learninglabdtu/CardReader/README.md

CardReader
==========

RFID Card Reader lock for closets.
