learninglabdtu/CardReader/BOM.ods

Component types | Component | Value | PCBA | RC number | Link
 | PCB-SENNHEISER_CHARGER_readout
Photo resistors | JP 1, JP 2, JP3, JP4 | EG&G LDR VT935G | 30 in stock | 455-8036 | http://dk.rs-online.com/web/p/ldr-light-dependent-resistors/4558036/?searchTerm=455-8036
Resistors | R3, R6, R9, R12 | 10k | √ | 740-8899 | http://dk.rs-online.com/web/p/overflademontering-faste-modstande/7408899/?searchTerm=740-8899 (http://dk.rs-online.com/web/p/keramiske-flerlags-kondensatorer/7236017/?searchTerm=723-6017)
 | R1, R4, R7, R10 | 330R | √ | 740-8931 | http://dk.rs-online.com/web/p/overflademontering-faste-modstande/7408931/?searchTerm=740-8931
 | R2, R5, R8, R11 | 100k | √ | ?
LEDs | U$1, U$4, U$7, U$ 10 |  | buy! | 708-2747 | http://dk.rs-online.com/web/p/lysdiode-led-med-synligt-lys/7082747/?searchTerm=708-2747
Capacitors | C1, C2, C3, C4 | 10uF | √ | 723-6017 | http://dk.rs-online.com/web/p/keramiske-flerlags-kondensatorer/7236017/?searchTerm=723-6017
 | C5 | 100nF | √ | 698-3327 | http://dk.rs-online.com/web/p/keramiske-flerlags-kondensatorer/6983327/?searchTerm=698-3327
Ics | IC1 | 4050D | 8 in stock | 483-6544 | http://dk.rs-online.com/web/p/buffer-og-line-driver-kombinationer/4836544/?searchTerm=483-6544
 | PCB-CARDLOCK
Resistors | R1, R2 | 1k5 | ~100 in stock | 740-8903 | http://dk.rs-online.com/web/p/overflademontering-faste-modstande/7408903/?searchTerm=740-8903
 | R3, R4, R5, R18 | 270R | √ | 213-2193 | http://dk.rs-online.com/web/p/overflademontering-faste-modstande/2132193/?searchTerm=213-2193
Capacitors | C1, C4, C5 | 100nF | √ | 698-3327 | http://dk.rs-online.com/web/p/keramiske-flerlags-kondensatorer/6983327/?searchTerm=698-3327
 | C3 | 10uF | √ | 723-6017 | http://dk.rs-online.com/web/p/keramiske-flerlags-kondensatorer/7236017/?searchTerm=723-6017
 | C2 | 10uF/12V | buy! | 723-6562
Ics | IC1 | ULN2803A | √ | 646-6311 | http://dk.rs-online.com/web/p/darlington-transistorer/6466311/?searchTerm=646-6311
 | IC2, IC3 | MCP23017SS | √ | 681-1128 | http://dk.rs-online.com/web/p/i-o-expandere/6811128/?searchTerm=681-1128
 | OK1 | LTV826S | √ | 691-2209 | http://dk.rs-online.com/web/p/optoelektroniske-switches/6912209/?searchTerm=691-2209
Relays | Relay1, Relay2 | 5VIM03 | 22 in stock | 422-7029 | http://dk.rs-online.com/web/p/relaeer/4227029/?searchTerm=422-7029
Diodes | D1, D2, D3, D4, D5, D6 | ? | √ | ?
Leds | U$7 | Bi-color LED | 4 in stock | 228-5764 | http://dk.rs-online.com/web/p/lysdiode-led-med-synligt-lys/2285764/?searchTerm=228-5764
Buttons and switches | Reset button, angled |  | 10 in stock | 734-6811 | http://dk.rs-online.com/web/p/trykknapafbrydere-og-trykknapomskiftere/7346811/?searchTerm=734-6811
Others | SG1 | Buzzer | 8 in stock | 771-6917 | http://dk.rs-online.com/web/p/piezo-buzzer-komponenter/7716917/?searchTerm=7716917
Buttons and switches | U$4 | Navigation switch | 3 in stock | 516316 | http://dk.rs-online.com/web/p/joystick-switche/0516316/?searchTerm=516316
Connectors | M04X2 | Analog Detect | 20 in stock | 673-7587 | http://dk.rs-online.com/web/p/printstiftlister/6737587/?searchTerm=673-7587
 | J2 | Temp/Hum sensor connector | 90 in stock |  | http://www.seeedstudio.com/depot/grove-universal-4-pin-connector-p-789.html?cPath=44_80
 | X1, X2 | MSTVB53.5MM | 7 in stock | 3704841 | http://dk.farnell.com/phoenix-contact/1843635/header-vertical-3-5mm-5way/dp/3704841?Ntt=3704841
 | X1 plug, X2 plug |  | 4 in stock | 5089189 | http://dk.farnell.com/phoenix-contact/mcvw-1-5-5-st-3-5/plug-free-r-a-3-5mm-5way/dp/5089189?Ntt=5089189
 | X3 | MSTVB23.5MM | 3 in stock | 3704816 | http://dk.farnell.com/jsp/search/productdetail.jsp?SKU=3704816
 | X3 plug |  | 4 in stock | 5089153 | http://dk.farnell.com/jsp/search/productdetail.jsp?SKU=5089153
 | JP5 | 36 Header Post, single (sidelooking) | ... | 251-8452 | http://dk.rs-online.com/web/p/printstiftlister/2518452/?searchTerm=251-8452
 | JP3, JP9, Arduino headers | 36 Header Post, single (7top,3below) | ... | 251-8632 | http://dk.rs-online.com/web/p/printstiftlister/2518632/?searchTerm=251-8632
 | U$12, U$13 | M04X2 | same as Analog Detect | 251-8648 | http://dk.rs-online.com/web/p/printstiftlister/2518648/?searchTerm=251-8648
Others | RFID |  | 3 in stock |  | http://www.seeedstudio.com/depot/1356mhz-rfid-module-iosiec-14443-type-a-p-196.html?cPath=19_24
Arduinos | Arduino Ethernet |  | buy! | 769-7402 | http://dk.rs-online.com/web/p/processor-og-mikrocontroller-udviklingssaet/7697402/?searchTerm=769-7402
Others | Temperature Hum Sensor |  | 2 in stock |  | http://www.seeedstudio.com/depot/grove-temperaturehumidity-sensor-pro-p-838.html?cPath=25_27
Wires | 50cm wires |  | 10 in stock |  | http://www.seeedstudio.com/depot/grove-universal-4-pin-buckled-50cm-cable-5-pcs-pack-p-928.html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
Boxes | Hammond Box |  | 6 in stock | 773-2953 | http://dk.rs-online.com/web/p/kabinetter-allround/7732953/?searchTerm=773-2953
Schaeffer stuff | Shaeffer aluminium
 | Shaeffer plastics
