learninglabdtu/CardReader/Eagle/PCB-CARDLOCK/PCB-CARDLOCK_bottom.pdf

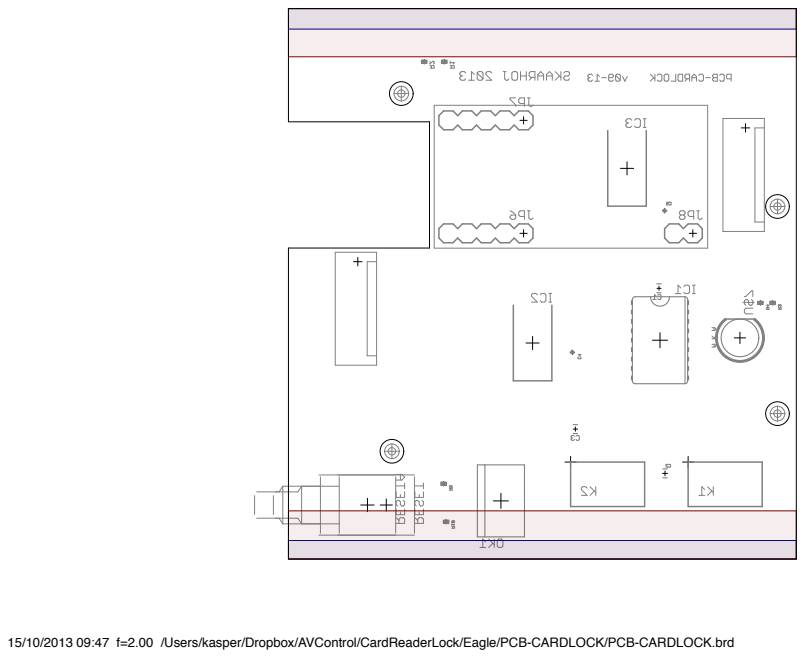
[picture p1: page 1]

15/10/2013 09:47 f=2.00 /Users/kasper/Dropbox/AVControl/CardReaderLock/Eagle/PCB-CARDLOCK/PCB-CARDLOCK.brd
