learninglabdtu/CardReader/Eagle/PCB-CARDLOCK/PCB-CARDLOCK_top.pdf

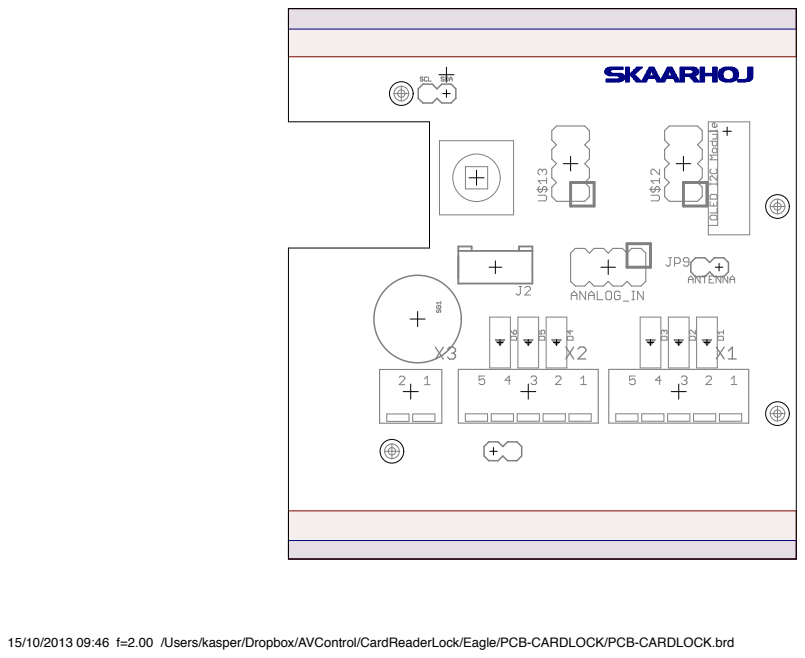
[picture p2: page 1]

15/10/2013 09:46 f=2.00 /Users/kasper/Dropbox/AVControl/CardReaderLock/Eagle/PCB-CARDLOCK/PCB-CARDLOCK.brd
