learninglabdtu/CardReader/Eagle/PCB-SENNHEISER_CHARGER_readout/PCB-SENNHEISER_CHARGER_readout.brd

## EAGLE design Eagle/PCB-SENNHEISER_CHARGER_readout/PCB-SENNHEISER_CHARGER_readout.brd (2014-01-15)

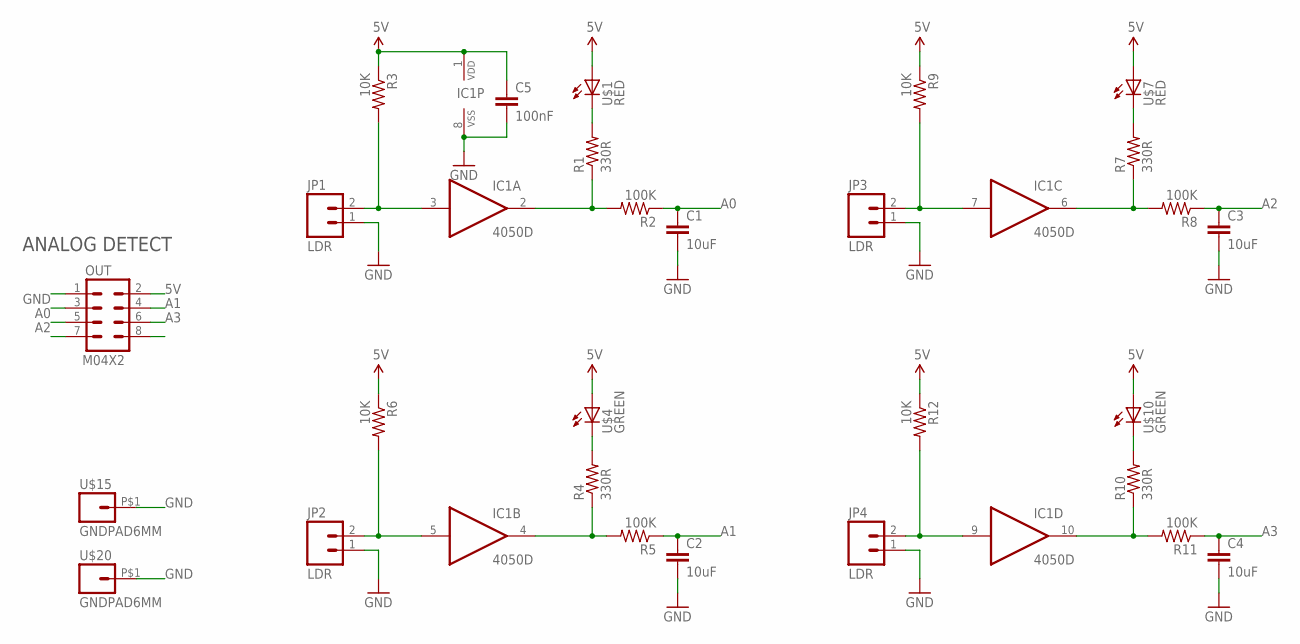
[picture p3: schematic PCB-SENNHEISER_CHARGER_readout.sch, sheet 1]

Parts:
C1, C2, C3, C4: 10uF; 0603-CAP
C5: 100nF; 0603-CAP
IC1: 4050D; SO16
JP1, JP2, JP3, JP4: LDR; 1X02
OUT: M04X2; 2X4
R1, R4, R7, R10: 330R; 0603-RES
R2, R5, R8, R11: 100K; 0603-RES
R3, R6, R9, R12: 10K; 0603-RES
U$1, U$7: RED; LED3MM
U$4, U$10: GREEN; LED3MM
U$15, U$20: GNDPAD6MM; 3.2MMPAD6MM

Connections:
5V: C5.1, IC1.1 (VDD), OUT.2, R3.1, R6.1, R9.1, R12.1, U$1.A, U$4.A, U$7.A, U$10.A
A0: C1.1, OUT.3, R2.1
A1: C2.1, OUT.4, R5.1
A2: C3.1, OUT.5, R8.1
A3: C4.1, OUT.6, R11.1
GND: C1.2, C2.2, C3.2, C4.2, C5.2, IC1.8 (VSS), JP1.1, JP2.1, JP3.1, JP4.1, OUT.1, U$15.P$1, U$20.P$1
unnamed: IC1.3 (I), JP1.2, R3.2
unnamed: R1.2, U$1.K (C)
unnamed: IC1.2 (O), R1.1, R2.2
unnamed: IC1.5 (I), JP2.2, R6.2
unnamed: R4.2, U$4.K (C)
unnamed: IC1.4 (O), R4.1, R5.2
unnamed: IC1.7 (I), JP3.2, R9.2
unnamed: R7.2, U$7.K (C)
unnamed: IC1.6 (O), R7.1, R8.2
unnamed: IC1.9 (I), JP4.2, R12.2
unnamed: R10.2, U$10.K (C)
unnamed: IC1.10 (O), R10.1, R11.2

Notes on the sheet:
ANALOG DETECT

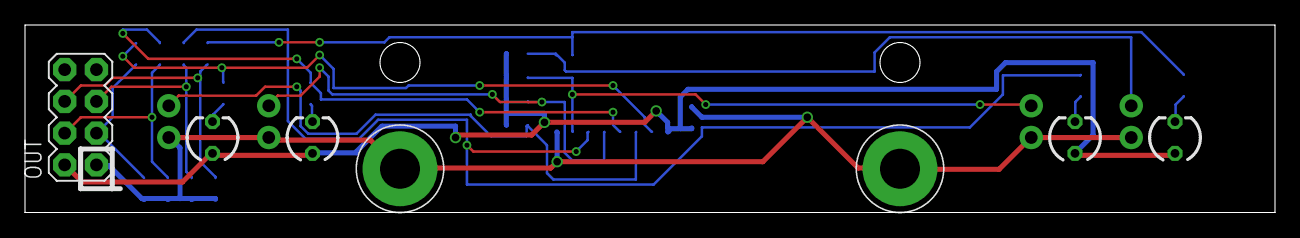
[picture p4: board PCB-SENNHEISER_CHARGER_readout.brd from above]

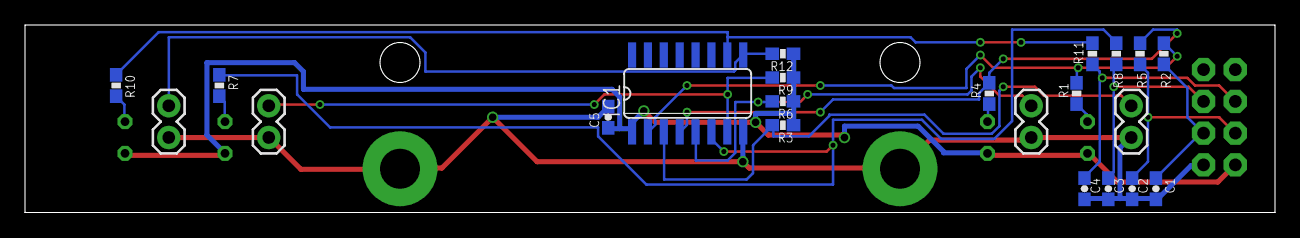
[picture p5: board PCB-SENNHEISER_CHARGER_readout.brd from below]

Board: 2 copper layers, 100.0 x 15.0 mm, 29 parts (22 on the bottom side), 18 nets.
