learninglabdtu/CardReader/Eagle/PCB-CARDLOCK/PCB-CARDLOCK.brd

## EAGLE design Eagle/PCB-CARDLOCK/PCB-CARDLOCK.brd (2014-01-15)

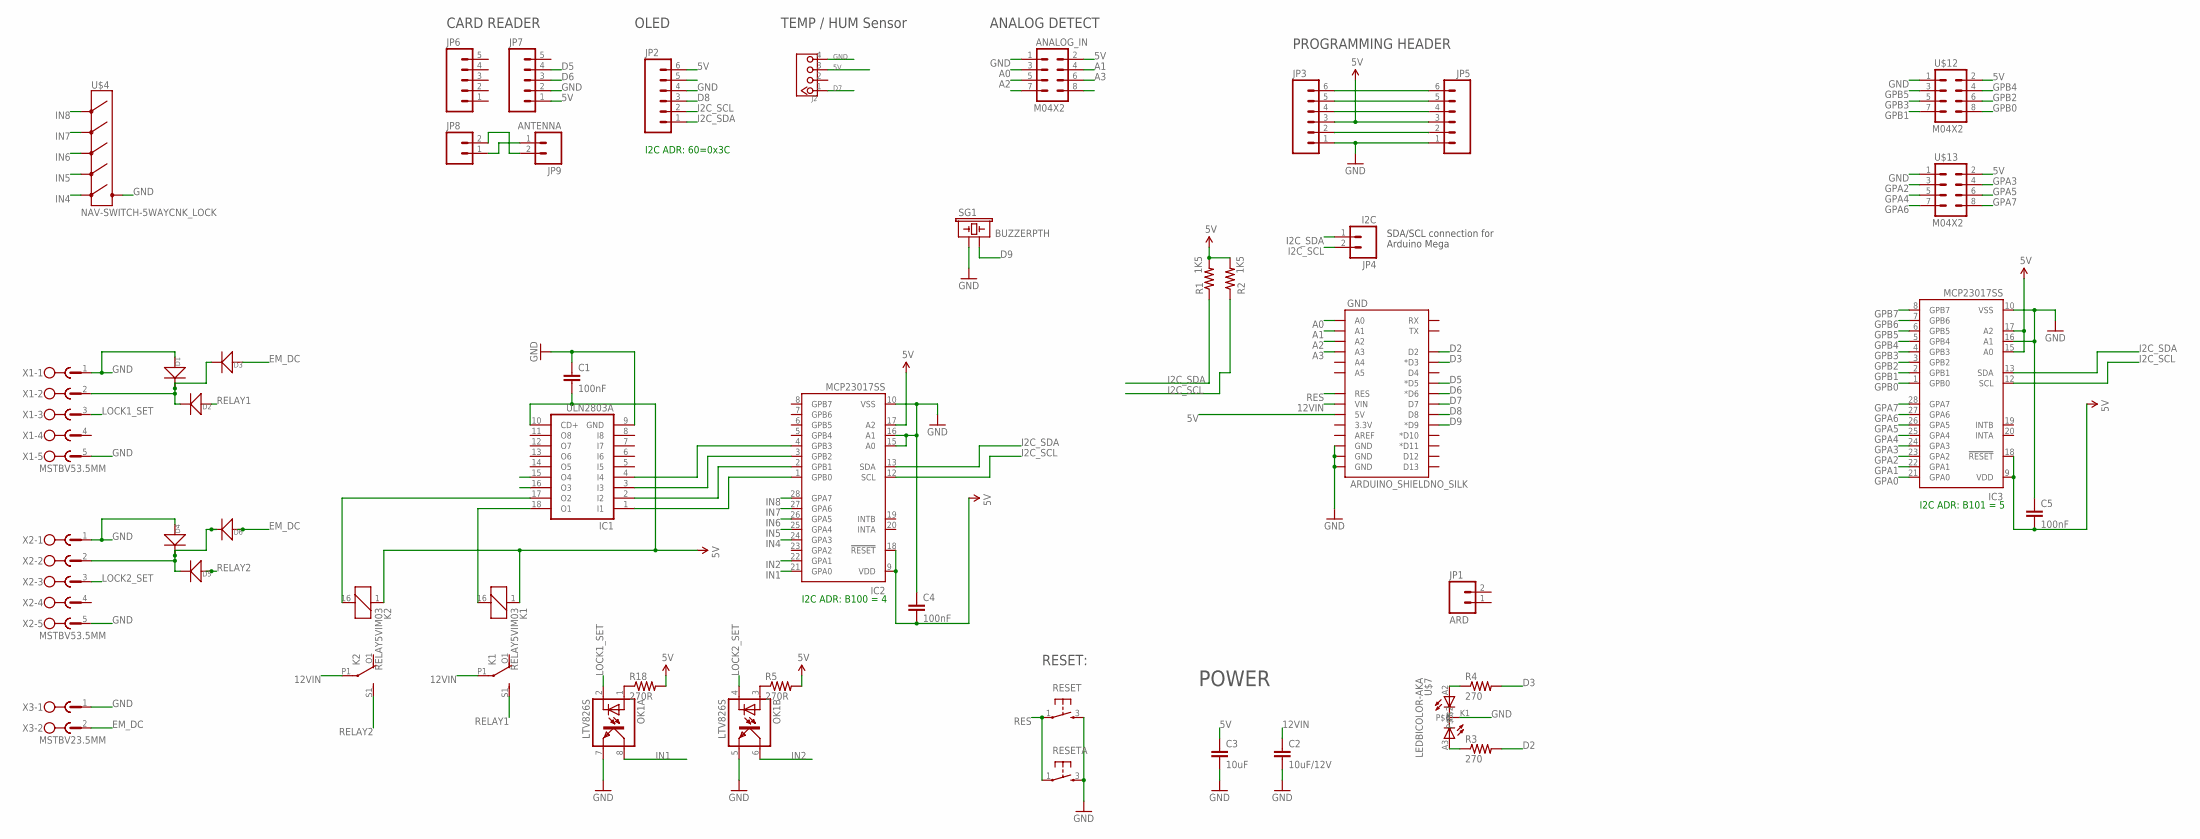
[picture p6: schematic PCB-CARDLOCK.sch, sheet 1]

Parts:
ANALOG_IN: M04X2; 2X4
C1: 100nF; 0805
C2: 10uF/12V; 0805
C3: 10uF; 0805
C4, C5: 100nF; 0603-CAP
D1, D2, D3, D4, D5, D6: D-SMA; DO-214AC
GND: ARDUINO_SHIELDNO_SILK; DUEMILANOVE_VIAS
IC1: ULN2803A; SO18W
IC2, IC3: MCP23017SS; SSOP28
J2: TWIG-4P-2.0-2.0; 4P-2.0
JP1: ARD; 1X02
JP2, JP3, JP5: M06POLAR; MOLEX-1X6
JP4: I2C; 1X02
JP6, JP7: M05PTH; 1X05
JP8: M02PTH; 1X02
JP9: ANTENNA; 1X02
K1, K2: RELAY5VIM03; DS2Y
OK1: LTV826S; DIL8-SMD
R1, R2: 1K5; 0603-RES
R3, R4: 270; 0603-RES
R5, R18: 270R; 0603-RES
RESET: TAC_SWITCH; PUSHBUTTON
RESETA: TAC_SWITCH; PUSHBUTTON
SG1: BUZZERPTH; BUZZER-12MM
U$4: NAV-SWITCH-5WAYCNK_LOCK; NAV-SWITCH-5WAY
U$7: LEDBICOLOR-AKA; LED5MM-BICOLOR
U$12, U$13: M04X2; 2X4
X1, X2: MSTBV53.5MM; MSTBV5-3.5
X3: MSTBV23.5MM; MSTBV2-3.5

Connections:
5V: ANALOG_IN.2, C1.2, C3.1, C4.2, C5.2, GND.5V, IC1.10 (CD+), IC2.9 (VDD), IC2.17 (A2), IC2.18 (!RESET), IC3.9 (VDD), IC3.15 (A0), IC3.17 (A2), IC3.18 (!RESET), J2.3, JP2.6, JP3.3, JP5.3, JP7.1, K1.1, K2.1, R1.2, R2.2, R5.2, R18.2, U$12.2, U$13.2
12VIN: C2.1, GND.VIN, K1.P1, K2.P1
A0: ANALOG_IN.3, GND.A0
A1: ANALOG_IN.4, GND.A1
A2: ANALOG_IN.5, GND.A2
A3: ANALOG_IN.6, GND.A3
D2: GND.D2, R3.2
D3: GND.D3 (*D3), R4.2
D5: GND.D5 (*D5), JP7.4
D6: GND.D6 (*D6), JP7.3
D7: GND.D7, J2.1
D8: GND.D8, JP2.3
D9: GND.D9 (*D9), SG1.- (2)
EM_DC: D3.1 (+), D6.1 (+), X3.2
GND: ANALOG_IN.1, C1.1, C2.2, C3.2, C4.1, C5.1, D1.1 (+), D4.1 (+), GND.GND@0 (GND), GND.GND@1 (GND), GND.GND@2 (GND), IC1.9 (GND), IC2.10 (VSS), IC2.15 (A0), IC2.16 (A1), IC3.10 (VSS), IC3.16 (A1), J2.4, JP2.4, JP3.1, JP5.1, JP7.2, OK1.5 (EMIT), OK1.7 (EMIT), RESET.3, RESETA.3, SG1.+ (1), U$4.PIN4 (COMMON), U$7.K1, U$12.1, U$13.1, X1.1, X1.5, X2.1, X2.5, X3.1
GPA0: IC3.21 (GPA0)
GPA1: IC3.22 (GPA1)
GPA2: IC3.23 (GPA2), U$13.3
GPA3: IC3.24 (GPA3), U$13.4
GPA4: IC3.25 (GPA4), U$13.5
GPA5: IC3.26 (GPA5), U$13.6
GPA6: IC3.27 (GPA6), U$13.7
GPA7: IC3.28 (GPA7), U$13.8
GPB0: IC3.1 (GPB0), U$12.8
GPB1: IC3.2 (GPB1), U$12.7
GPB2: IC3.3 (GPB2), U$12.6
GPB3: IC3.4 (GPB3), U$12.5
GPB4: IC3.5 (GPB4), U$12.4
GPB5: IC3.6 (GPB5), U$12.3
GPB6: IC3.7 (GPB6)
GPB7: IC3.8 (GPB7)
I2C_SCL: IC2.12 (SCL), IC3.12 (SCL), JP2.2, JP4.2, R2.1
I2C_SDA: IC2.13 (SDA), IC3.13 (SDA), JP2.1, JP4.1, R1.1
IN1: IC2.21 (GPA0), OK1.8 (COL)
IN2: IC2.22 (GPA1), OK1.6 (COL)
IN4: IC2.24 (GPA3), U$4.PIN6 (PUSH)
IN5: IC2.25 (GPA4), U$4.PIN5 (RIGHT)
IN6: IC2.26 (GPA5), U$4.PIN2 (LEFT)
IN7: IC2.27 (GPA6), U$4.PIN3 (DWN)
IN8: IC2.28 (GPA7), U$4.PIN1 (UP)
LOCK1_SET: OK1.2 (C), X1.3
LOCK2_SET: OK1.4 (C), X2.3
unnamed: D1.2 (-), D2.2 (-), D3.2 (-), X1.2
unnamed: JP8.1, JP9.1
unnamed: JP3.4, JP5.4
unnamed: IC1.18 (O1), K1.16 (2)
unnamed: D4.2 (-), D5.2 (-), D6.2 (-), X2.2
unnamed: IC1.1 (I1), IC2.1 (GPB0)
unnamed: R4.1, U$7.A2
unnamed: JP3.5, JP5.5
unnamed: IC1.17 (O2), K2.16 (2)
unnamed: JP8.2, JP9.2
unnamed: R3.1, U$7.A3
unnamed: JP3.2, JP5.2
unnamed: IC1.2 (I2), IC2.2 (GPB1)
unnamed: IC1.3 (I3), IC2.3 (GPB2)
unnamed: IC1.4 (I4), IC2.4 (GPB3)
unnamed: OK1.3 (A), R5.1
unnamed: OK1.1 (A), R18.1
unnamed: JP3.6, JP5.6
RELAY1: D2.1 (+), K1.S1 (S)
RELAY2: D5.1 (+), K2.S1 (S)
RES: GND.RES, RESET.1, RESETA.1

Notes on the sheet:
SDA/SCL connection for
Arduino Mega
POWER
RESET:
PROGRAMMING HEADER
OLED
CARD READER
TEMP / HUM Sensor
ANALOG DETECT
I2C ADR: B100 = 4
I2C ADR: 60=0x3C
I2C ADR: B101 = 5

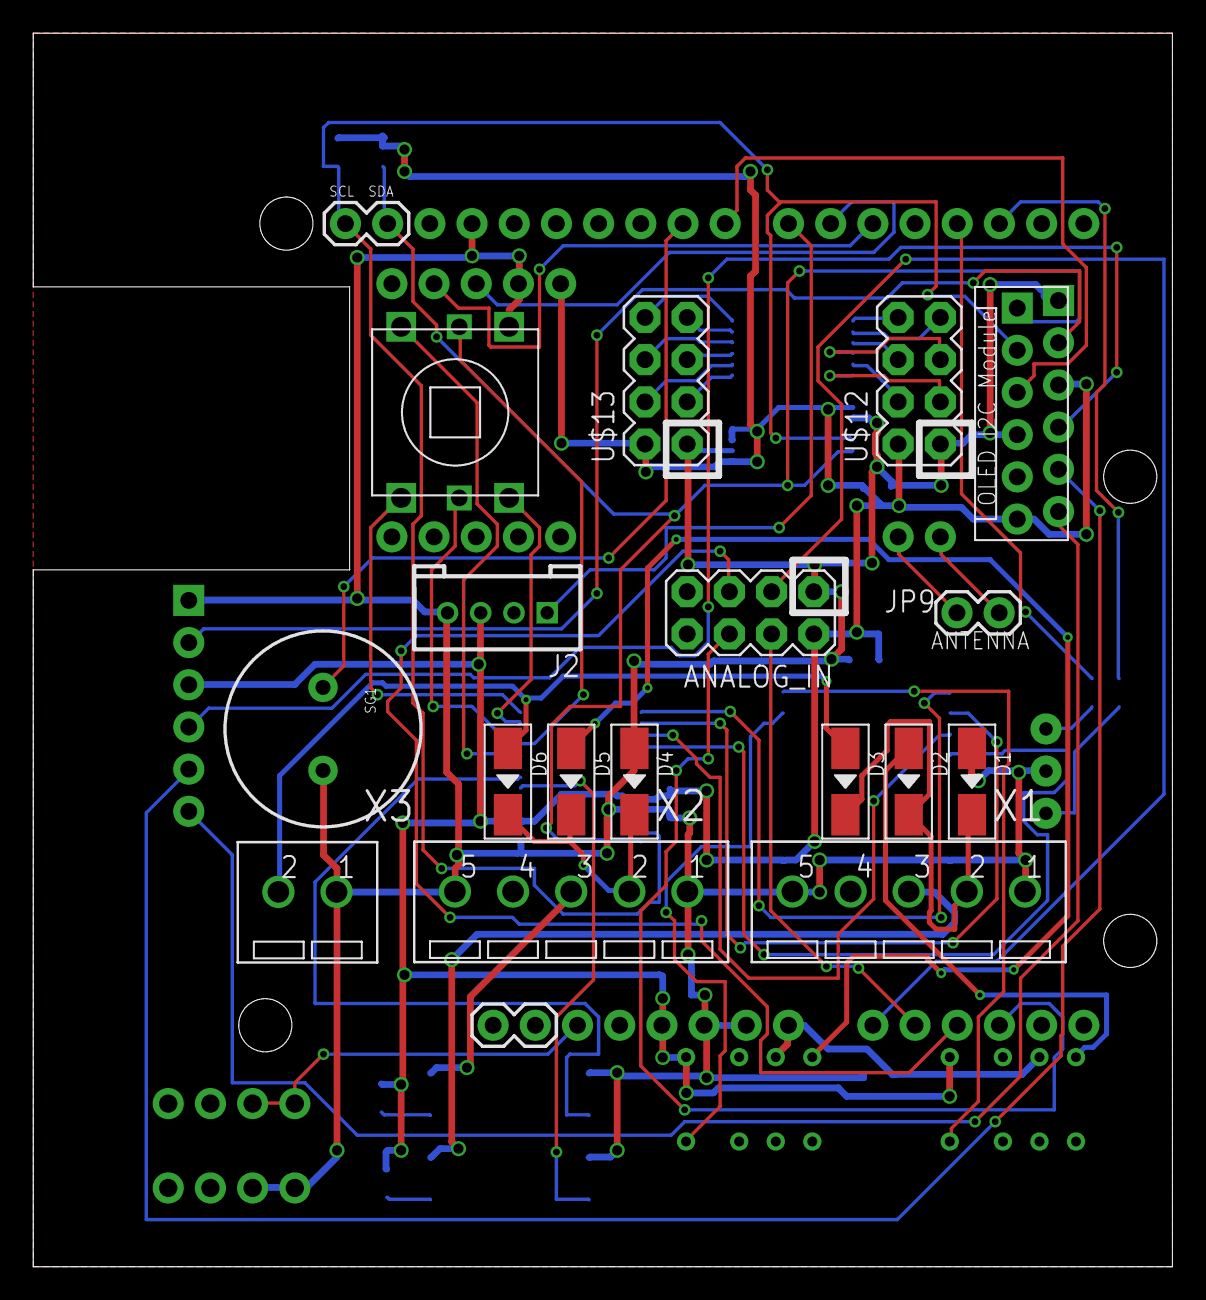
[picture p7: board PCB-CARDLOCK.brd from above]

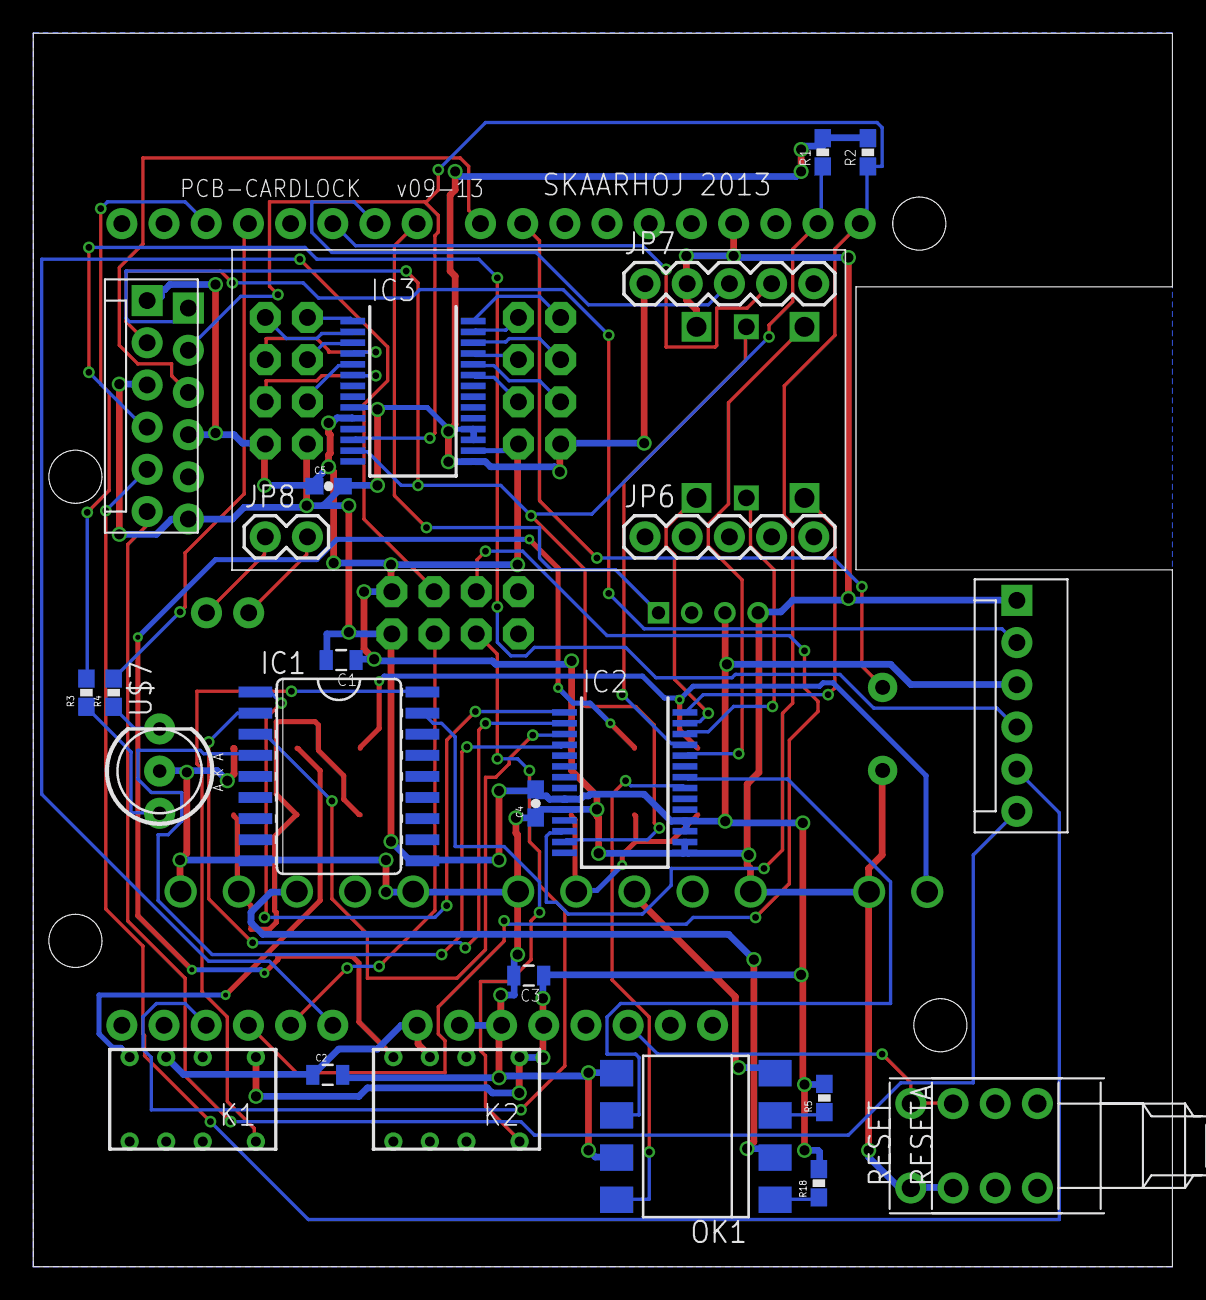
[picture p8: board PCB-CARDLOCK.brd from below]

Board: 2 copper layers, 68.6 x 74.3 mm, 45 parts (25 on the bottom side), 59 nets.
