learninglabdtu/CardReader/Assembly Notes.rtf

(Plastic beskyttelse til nøgle)
(Alu beskyttelse til stik på cardreader box)

Mounting:
- Bolts sandwich: top / 3+0.5mm spacing / print / 0.5mm fiber + 5mm nut + 6mm spacertube / arduino / fiber-spacer 0.5mm + M3 nut.
- Make sure board for access card reader doesn't touch crystal. Solder few pins and test spacing. Cut pins on solderside to fit in box
- Observe pins for reset button and relays!!
- Notice: C2 is 12V!
